charcole/LCDZapper/Images/LCDZapperPro4.jpg

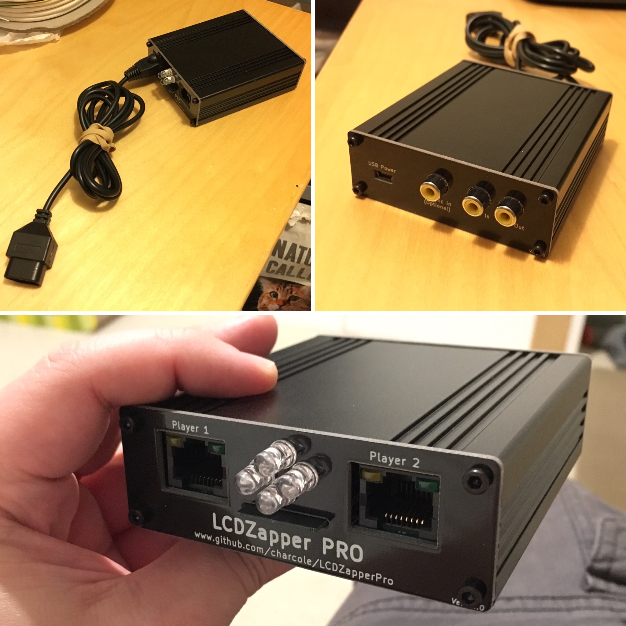
Images/LCDZapperPro4.jpg
