charcole/LCDZapper/Images/LCDZapperPro.jpg

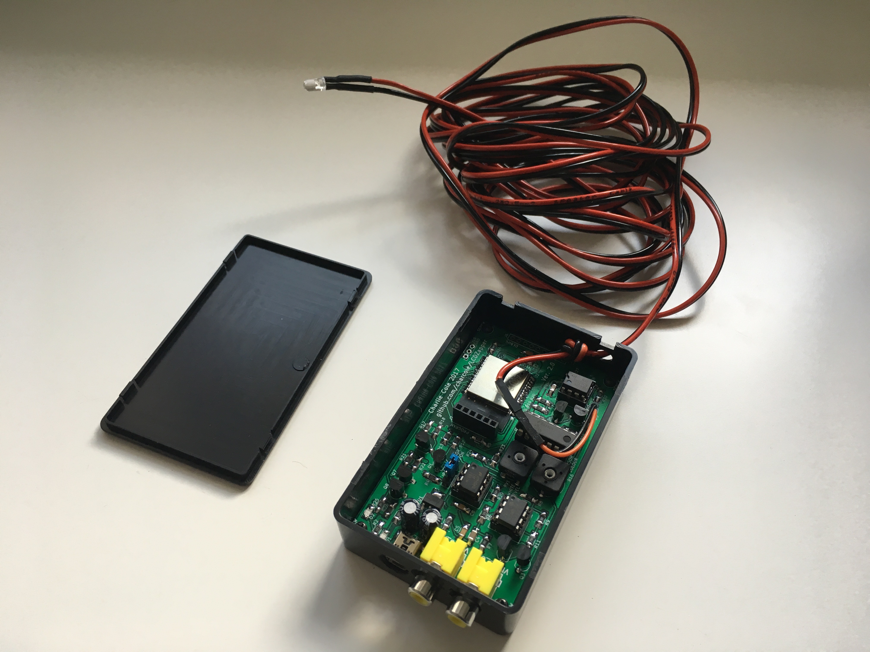
Images/LCDZapperPro.jpg
