charcole/LCDZapper/KiCad/SCARTBreakout/3DModel.png

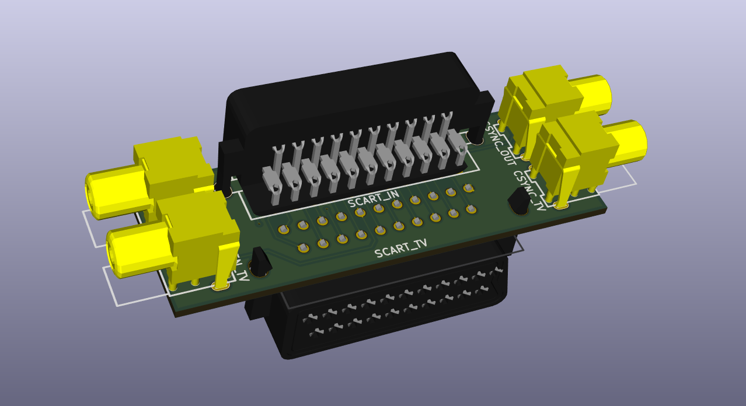
KiCad/SCARTBreakout/3DModel.png
