charcole/LCDZapper/OriginalPrototype/AnalogueBoard.jpg

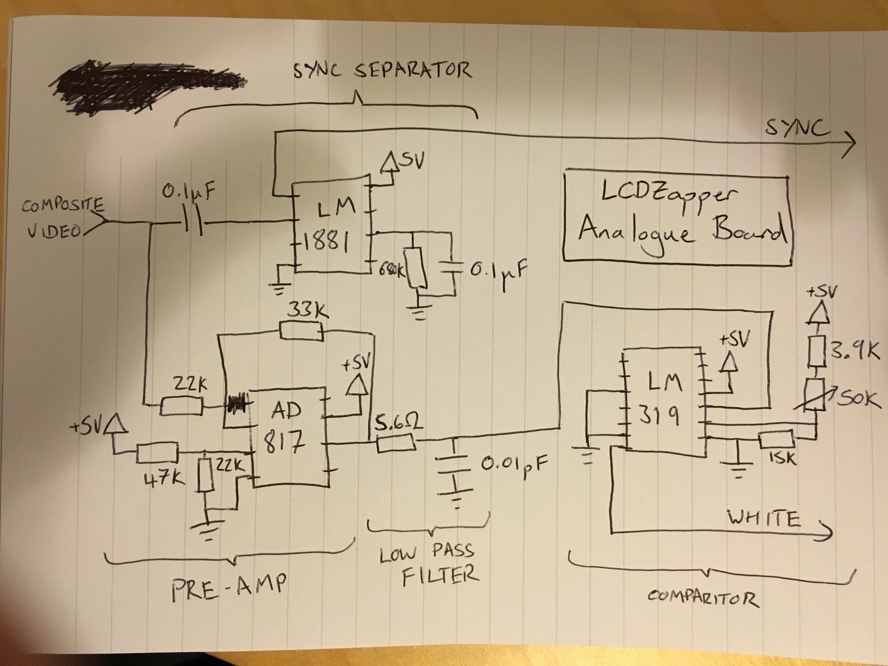
OriginalPrototype/AnalogueBoard.jpg
