charcole/LCDZapper/(threads)

Thread 1 (2016-08-31):

Schematic and board creation

muramasatheninja, 2016-08-31:
Hi,

Very excited to see this project. I wasn't sure the best way to contact you so I figured I would post an issue here.

I started on converting your hand drawn schematic.
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

The goal is to make a self contained board that would fit in a small enclosure.

Thanks

muramasatheninja, 2016-09-02:
One thing I'm a little confused about is how the 2N7000 is used to add the reticule on the screen. I looked pretty closely at your video to see how you had it setup but wasn't able to spot it. Is there any reason to use a transistor over say just a switch to switch the video between the resistor and one that let's the signal straight through?

dlcboy, 2016-09-21:
First off just let me say this is absolutely brilliant work!!  I've been struggling for years to find a good solution to this problem and you nailed it, home run, out of the park! Bravo! I was actually buying the parts to build a similar albeit less capable system when I stumbled across your work searching to see if anybody had done this for the millionth time, and what a pleasant surprise to see it!

Seeing as how you have it done so well,  is there anything we can do to contribute and make it better? I wondered about making a logic system for the wiimote so that it can track dots actually located at the corners of the tv so there is no need for calibration and the user can move around freely? I could try putting retro reflective stickers on the tv with an ir led light source so they wouldn't need power?  I could work on sensor fusion with the wifi motion plus if you think that could be better with the help of the inertial system to increase accuracy? Your video looked pretty good already I have to say, maybe the wiimote has less noise than I expected.

Btw, muramasatheninja, imho, I suspect the 2n7000 is just being used exactly like you said, as a really fast switch... in its saturation region, just pulling the signal low briefly. Please correct if I'm wrong though!

Thanks again for the great work!! I'm anxious to get this running soon!

ysfgary, 2016-10-24:
Hi, I would like to start this project but I am using NTSC system. Any design I need to change it before I start this project? Thanks.

Catwashere, 2017-01-02:
Pretty sure 2n7000 is to remove saturation.

muramasatheninja, probably you could spot it because is attached to the input and output
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

charcole, 2017-03-12:
Hi everyone,

First I've got to give a big apology. I never got a notification of this thread. I only spotted it because I'm currently working on a version 2 and wanted to look at my schematic. Thanks for the schematic muramasatheninja. I would add it but I don't want to produce any notifications at the moment as version 2 is quite close now (hopefully!).

The 2N7000 to dim is really dodgy and something I want to improve for the second version. I should say I'm mainly a programmer and not that great at analogue electronics. It worked but I don't think it was correct. The idea was to have another resistor in series with the video signal and short circuit it with the FET. When the FET was off the signal would go through the resistor causing some voltage to be dropped and therefore the display to dim. And when on it should let the signal through with only a slight drop in the FET.

However it's dodgy because the DC bias of a video signal is not set. It worked fine on the NES as it was about 3V. In more modern systems it tends to be 0V which means the signal is negative for half the time. When negative the current will flow through the diode in the FET and the gate to source voltage can go positive even when grounded. It seemed to work in this configuration but I wasn't very happy with it and the 2N7000 tended to die randomly and need replacing (too much current through the diode or static?). Also if the DC bias was high the resistor would cause the screen to dim more than if it was low.

For version 2, I was planning on improving this by putting the signal through a capacitor so I can fix the DC bias and then to an op-amp. This way the DC levels and driving circuitry is a known quantity. From there I can use two 2N7000s to switch between that output and a variable voltage source. This way the cursor can be more visible and there can be a pot to change between a white and black cursor.

In case people are interested, the other changes I was planning for V2, is replacing the Raspberry Pi and Arduino with an ESP32. It has bluetooth built in and I have it working with a Wiimote (it works a lot more reliably than with the Pi too as a bonus). The ESP32 is dual core so the other core can be used to do the precision timing needed to pick out parts of the frame (what the Arduino used to do). However the ESP32 also has a peripheral that should be able to do it without much CPU time so that's what I'm planning to use. Finally I'm going to use a 555 timer to use the dimming signal and the output from the comparator to flash the LED so the ESP32 don't need to listen to the white level like the Arduino did. Tested everything in stages, just need to go through and build it up. In all it should be a much neater product and have better tolerances than the old RPi/Arduino method.

Thanks,
Charlie

charcole, 2017-03-12:
dlcboy: Zero calibration would be good. I'm wondered about adding four IR LEDs to the corner of the TV. Problem would come if the system could only see one LED and it wouldn't know what corner it was seeing. You could try and keep track of the points (last time I saw one around here it was the top left LED). Your idea of using the accelerometer could add some more data to this to make it more accurate. Or the micro could control the LEDs and flash them in sequence if unsure which it was looking at. It's something that's on my mind but will try and get V2 working first. It'd just be software from then on.

ysfgary: Hi. NTSC would be cool. I think the only thing that'd need to change would be the timings and the line number calculations. It shouldn't need hardware changes. Might be worth waiting for V2 now though.

Catwashere: Good spotting

Catwashere, 2017-03-13:
Can't wait to see V2 and see if you convince me to buy an ESP32.

Please this time put the schematic hahahaha.

Greyneon, 2017-03-16:
Was looking at this about a week ago or so and now i hear about a version 2?

I am SO subscribing to this!

muramasatheninja, 2017-03-24:
Thanks for the update. Definitely looking forward to Version 2!

charcole, 2017-04-03:
Another quick update for you all. Got the Version 2 working at the weekend on strip board. This is the new analogue board with the ESP32 handling Bluetooth (for Wiimote) and generating the video overlay. Video overlay stability is a lot better this time around. Next steps are to make a schematic (probably in KiCad) and layout a PCB so it can be sent off to be fabricated. Hopefully that shouldn't take too long.

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

Greyneon, 2017-04-10:
Awesome news! Can't wait :D

Catwashere, 2017-04-10:
Me too

charcole, 2017-04-15:
Another update for you. So, last week I finished off laying out the PCB and sent it off to the fabricators. Expecting the first batch of boards back in the next couple weeks. From there I just need to assemble them to ensure I didn't mess anything up and improve the software side of things ready for release.
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

dlcboy, 2017-04-15:
Awesome work!! I'm so excited to see this moving along!!!! When it went quiet I had thought you might have moved on to something else. I tried and tried to get wii library support working on my pi and just failed, so I'm super excited to have something that's more robust and a bit more dedicated to this one task (which I will be using 100% of my free time of course;) are you making a handful of boards? Can I help in any way? I'd be happy to assemble or solder if you are doing it yourself. Also happy to help by donating enough beer to the cause to make it less painful too;)

 I can't wait to get one running to try out different sensor fusion schemes, and becon setups. I feel like it's pretty important for these old games to have dead on accuracy with minimum latency. Keep up the good work!! I can't wait to have duck hunt on my giant 2016 hdtv:D

charcole, 2017-04-16:
Thanks. Yeah, didn't have much free time the past year or so due to work but hopefully will start doing some more home projects again. I'm sure I'll have messed up something on these first batch of boards but if not I'm happy to send any left over unpopulated ones out if anyone wants one. I've just had confirmation they should get delivered on Thursday. As for completed boards, if I decide to sell some the PCB fabricators should be able to do almost all the assembly for a pretty reasonable cost but thanks for the offer. Whatever I do or not though, everything you'll need to build one will still get added to github.

Catwashere, 2017-04-17:
I'm in charcole, but I live in México. If you send me you paypal and cost I pay for the shipment.

jbp11, 2017-04-19:
This is fantastic!  I would gladly purchase a board.

charcole, 2017-04-20:
I said the boards should be here today so thought I should give another update. They actually turned up on Tuesday so I've already had time to populate one and check for mistakes. Surprisingly no major errors so they do work. I did make a mistake on the silkscreen (a resistor and capacitor label were switched). All the other problems were mechanical (screw holes too small, RCA jacks sit too high etc) but they don't matter if you aren't trying to fit it into the case I chose.

There are a couple minor issues too. For some reason the vertical position of the detection point jitters by a couple lines which I can't remember happening on my strip board version (it's not too noticeable as there's shake from holding the gun but I want to know what it is). Also one time it booted up and the APB clock seemed to be running at half rate which meant the detection point became stretched. Again, it's not a deal breaker as it came back fine after a reboot but I'd like to know what's going on there too.

As for sending boards out they are only 17 grams so should only be the cost of a letter so happy to pay postage to anywhere. Just to be clear these are just the bare PCBs with no components soldered on. You'll have to source the parts and solder everything, build the programming board (basically a couple switches and a USB to serial adapter) and set up the ESP32 tool chain. Also you might have to wait a while until I release the code and schematics as they are not quite ready yet. If you are still interested though then send me your address at cdcfoscam at yahoo.com and I'll pop them in the mail (I have 4 or 5 I probably won't use). Completed boards (just plug in and play) should be available at some point in the future if I can work out the economics of it.

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

rEd2k, 2017-04-23:
If you can think about possibly building the whole thing and make complete units ready to go, I'm sure people will buy them. You could sell them on websites that offer accessories for retro gaming ect. and since your the ONLY person doing this you can patent the product and be the only person out there that people can get these from making you rich! (Or maybe just more wealthy lol).

My 2 friends and I are already interested in buying a completed module, that's 3 people that will buy it, and all of the people we know that will want one as well and so on... You should really think about manufacturing these and going all the way, there isn't anyone else doing this so you have an edge. I hope you think about it and really consider what I have said, being a business owner myself I can see the potential here! Thank you for your hard work on this project so far, now it's time to take it all the way! ;)

charcole, 2017-04-23:
Thanks rEd2k. I'd certainly like to. Biggest stumbling block after reading up on the subject seems to be FCC regulations (and similar in other countries). Before selling an electronics product it needs to be tested for emissions and reading around it seems like you need to budget at least $10K (probably more like $20K) to get an intentional radiator through. The European regulations (which I'd have to adhere to) are less strict but selling something without doing the right testing could still be a huge fine or even a prison sentence. So starting small and selling a few doesn't seem like it's really an option from what I've read. I'm still investigating though. In the meantime I'm still working on the design, trying to make it as slick as possible. Currently working towards getting it to a state that a friend can beta test it.

rowie4life, 2017-04-24:
Do want.

jlebrech, 2017-04-26:
@charcole just sell as a kit, this is what edtracker did.

you might get away with people only need to solder one component or lead.

charcole, 2017-04-26:
Unfortunately kits are explicitly mentioned as still needing testing. My reading of it is selling the PCB would be fine but the PCB with any number of parts wouldn't. There's is an exemption for subassemblies which this could maybe fall into (and edtracker might) but I'd probably need to talk to someone who knows this area of law.

Other than this, I've been working away improving the circuit and trying out some ideas some friends suggested (adding IR LEDs to work as sensor bar & Wiimote-only mode). I still need to bug fix some of the problems I found (and exist on a second board I assembled). Then I'll do another revision.

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
(Version 2.0 board with a "hat" that'll get built into next revision)

kahhar, 2017-04-29:
Is there any possibility of adding HDMI capability?

I think it would be great to support a standard that seems to have some future lasting power--newer TVs are starting to remove composite and component inputs.

I'd love to be able to play these games on a high quality signal on my HDMI NES and the SNES, Playstation 1/2, and Dreamcast via RGB -> HDMI converters.

Catwashere, 2017-04-29:
@kahhar even if you have an RGB or HDMI mod in your consoles if you don't disable default ports with the mod you can use this, the only feature you will be missing will be the "cheat" cross/circle on the display where you are pointing

Catwashere, 2017-04-29:
@charcole Wiimote-only mode? What does that mean?

IR Led sensor bar it will by a great add on and easy to create because in last revision you need to have a costume sensor bar, a battery sensor bar or a wii connected on.

kahhar, 2017-04-29:
@Catwashere It will still work, but it will still require a composite port (and won't look as nice).

charcole, 2017-04-29:
@Catwashere Wiimote-only mode is playing light gun games without a light gun. In the picture I posted the device has a NES controller plug connected to it and it goes into the NES instead of the Zapper. Then you can play it totally with the Wiimote like a Wii game (A or B cause the trigger pull signal to be sent to the NES). It's just a little extra. I wondered if it might be an easier sell as it's slicker that way. Extra consoles could be supported with different leads (the 8-bit ones being especially easy).

@kahhar Adding HDMI would be a big change and make the device a lot more expensive and difficult to build so I probably won't, sorry. As Catwashere said if you can get composite out as well as RGB (which goes to HDMI convertor or SCART or whatever) it'll still function. The composite signal would go to the device and the RGB off to the TV (the composite output from the device would be left unconnected). You'd lose the reticule that I add but it's mainly useful for calibration and playing Wii style.

Snaid1, 2017-04-30:
I love this idea and can't wait to try it out once you get to the point you're happy with!

just a quick question, would the wiimote-only mode be an option in addition to being able to play with a light gun or would it replace the use of the gun altogether?

charcole, 2017-05-03:
As you might have noticed I've uploaded new Kicad files to a "version2" branch. It's not final (got plenty of ideas to make it better) but it matches the few boards I've sent out and the ones I've been testing with. (Nb. The R10/C3 silkscreen labels are correct in the uploaded file but were wrong on the boards I sent out so take care).

@Snaid1 Yes, the wiimote-only mode is an option. You'll still be able to play with any light gun too, it'll just be two different leads.

ddbehsnilian, 2017-06-10:
@charcole thank you for coming up with this amazing solution! I'd like to follow this project as closely as I can, is this the best place to do so?

charcole, 2017-06-10:
Hi @ddbehsnilian, Yes, this is the best place. Updates have been a bit lacking recently because I haven't had much time to work on it. Hoping to publish the code soon though. If I'm organised I will do it as three projects, this, a standalone Wiimote library and (very niche) a CD-i controller which also use ESP32 & Wiimote.

wilhouse55, 2017-06-25:
I would def be interested in purchasing an NTSC setup that requires as little work on my end as my soldering skills are non-existent!

charcole, 2017-07-01:
Had some time off this week so there's finally been some progress again! :) You should find that the firmware is now released and I've added a description of the little programming board that is needed to update the firmware. I've also updated the README with some descriptions of the new features. As version2 is now more fully featured than the old Raspberry Pi/Arduino solution I've finally merged the version2 branch into master so it'll be the first one you find when visiting the project on github.

The firmware incorporates some hardware design changes I'm planning to make but I think it should still work with the current boards. The bits that won't work are turning off the cursor with the Home button (on the old boards it was a jumper) and two player will always be in co-op mode. I can discuss how to mod the changes into existing boards if anyone wants me to.

Biggest issue left is I've still got to investigate the jitter in the image (which is more noticeable now we have some rudimentary text being displayed). Next big thing is I need to support tracking two spots so you can roll the Wiimotes. I also want to add in a logo on power up to make it a bit cooler looking. I'm also planning on removing the LM1881 from the design as they are expensive to get from proper suppliers (although dirt cheap on eBay). This will require a little bit of code changes to support (but again shouldn't break the existing boards). While I think of it, when in two player it'd be good to have different cursors too. Sure I'll think of more things to improve but the version committed should be a decent first release.

ddbehsnilian, 2017-07-02:
This is fantastic news! Are you giving any thought into adding support for NTSC signal as well as PAL? If you're planning on selling this solution that would considerably enlarge the market for it. I hope you can put whatever time you think is necessary into making this a great product.

charcole, 2017-07-02:
I have indeed. All the timing constants are grouped together in one place. As the line frequency of NTSC and PAL are very similar only TIMING_VISIBLE_LINES probably needs changing to get it to work. There are a bunch of others in the group but mainly they only need adjusting to maintain aspect ratios. The current set of constants were just eye-balled so I probably need to revisit them and set them to proper PAL timings. When I do that I'll add the NTSC timings too.

charcole, 2017-07-02:
Committed a few new changes this evening...
- Jitter problems have been much improved (Not completely fixed yet as not sure why it's happening)
- Added logo on boot
- Replaced low resolution (12 by 5 pixel) text with images
- Made code change that allows removal of LM1881 (works off composite sync only)
- Player 2 now has a different shaped reticule (a diamond)

So that leaves (on the software side of things) a proper jitter fix, tracking two spots for controller roll and finalising PAL/NTSC timings.

cr4zymanz0r, 2017-07-09:
Is there a list of what all lightguns this has been found to be compatible/incompatible with?
I'm very curious if it works with PS2 Guncons So i can play Time Crisis 2 and 3.

charcole, 2017-07-09:
It should be universal so PS2 should work fine. I have been slowly gathering up light guns and consoles to test including PS2. In my original video I think I did NES, Saturn and Dreamcast. I've now also got Master System, PS1 and PS2. I'm missing a Superscope and Menacer but I hope to be able to borrow those. I've also got a Lethal Enforcers JAMMA arcade board being delivered that I plan to test with it too. That should cover most things people will want to use with it.

cr4zymanz0r, 2017-07-09:
I greatly appreciate this project since one of the main reasons I've been unable to get rid of aging CRTs is due to needing them for lightgun games. When using RGB output from consoles paired with devices such as the Framemeister or OSSC (no lag added!) these old console look stunning on HDTVs. Lightgun compatibility with LCDs is one of the last things I need for a "perfect" setup. I don't what your final plans are for the layout of this, but I thought I'd just give my thoughts as feedback.

1.) All of my retro consoles are using RGB with csync. I'm hoping I can just feed the csync into your device and then send the output from the device to my upscaler/whatever (or not send the output and just not have extra features like the on-screen cursor?)

2.) Strapping a wiimote to each light gun is probably the simplest solution with it being easily available, but it adds more weight and isn't very elegant in my opinion. Is the wiimote being used soley for IR tracking (and bluetooth for connectivity)? I didn't know if there's some mass produced components that could be used instead and just modded into the light guns. If not, I wonder if the bare wiimote PCB is small enough to be put into lightguns (and needed buttons added externally) all while possibly being able to be powered by the voltage provided to the light gun from the console.

I realize it would be impractical for you to be modding every single light gun per order, but it could be an option for a kit such as:
Kit A - most consumer friendly version meant for strapping a wiimote
Kit B - For more advanced users/modders that want a more elegant integrated solution.

charcole, 2017-07-09:
Yeah, the real problem is making a product enough people will want to buy to make it worth while. I remember hearing about some people who were modding Dreamcast Guns to fit Wiimote internals in them. I haven't looked into it though. Seemed like a very low volume thing. Similarly there are some old commercial IR based light-guns out there (for CD-i/PS3 etc) but they are expensive and hard to find. Most people probably have a Wiimote already (so free) although as you say not the most elegant solution.

Thanks for your comments on csync. The sync separator and video pass-through are different circuits so I could make a small modification to the board to allow you to optionally provide a separate csync signal and have the overlay added to whatever colour channel you pass through the normal composite video path. I'll experiment with that when my arcade board turns up as that'll be RGB with CSYNC. I'll then incorporate it into the next version of the board.

retrorgb, 2017-07-10:
I think there would be a ton of interest in this.  Would you be able to do a skype interview for my podcast and see what people think?  Please contact me if you're interested:  http://www.retrorgb.com/contact.html

ddbehsnilian, 2017-07-10:
Hope you accept the invite! @retrorgb does a great job maintaining the classic gaming community at its peak! His YouTube channel is really worth checking out too http://www.youtube.com/user/RetroRGB

mbrener, 2017-07-12:
Hi I'm building one of these to get two guncon 2 controllers up and running for Tim Crisis 2/3 on PS2. I'm making a few hardware changes and would like to know your thoughts. I'm going to use a NAND gate to drive the 555 timers. I'm also considering using a TXB0108 level converter to shift digital signals between 3V3 and 5V. I've been trying to decide on the video dim circuit. Does it affect the output scalling the input by 2? From what I can tell of your last posted circuit you are using two 2n7000 to disconnect the input signal and connect a ref voltage? How fast does the transition need to stabalise to work? The settling caused by switching of the fets may be contributing to your jitter. Have you considered using a high speed video mux? I found this link for a cheap mux circuit but I think the transitions are too slow (http://www.analog.com/en/analog-dialogue/articles/video-multiplexing-using-high-speed-amplifiers.html ).

charcole, 2017-07-12:
NAND gate and level shifter both sound like a sensible changes. I considered some dedicated video mux ICs but all the ones I found, in the price bracket at least, were too slow so abandoned the idea. I'm sure there are some around that'd be suitable. My switcher does cause some ringing (maybe caused by current draw on op-amp suddenly increasing). The ringing creates an unintentional but not unwelcome drop shadow on the overlay. A whole line's information is about 52 micro seconds so for one SD pixel is something like 80ns, so that's the sort of switching time we're aiming for.

The switching I don't think causes the jitter. The waveforms all look clean. Seems to instead be some interaction between the two cores of the ESP32. Once two Wiimotes are connected the jitter gets worse even though that all runs on a different core. The odd thing is it doesn't effect the horizontal sync in the same way which you'd think would be the harder of the two to get right.

BTW, For the people who are interested I've sent a message to RetroRGB about that interview.

boomchaU2, 2017-07-12:
Just came upon this as my wife is making get rid of my old CRT TV (I'll just relocate to shed, lol). This is a great idea and I will buy an NTSC version when you are ready!

dlcboy, 2017-07-12:
I've got a super scope I can lend you if you need it still.

Sent from my iPhone

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

charcole, 2017-07-13:
@dlcboy Thanks for the offer. I know someone locally with one though.

charcole, 2017-07-23:
Tiny update. Just to say I finally received the Lethal Enforcers JAMMA board I bought a couple weeks back so I've been able to test the device on that and happy to say it works. Another system crossed off the test list! :) I had no gun so wired up a two transistor interface that meant I could plug it directly into the board and play it just with a Wiimote. One new issue I found is there's no calibration settings and shots landed to the left of the cursor (the real light gun must have had a small delay between sensing and triggering). I'll see if I can think of a way of cheaply building this into the next device revision to make correcting these problems easier.

I was playing on my SuperGun with modified SCART cable. The red channel was broken out and fed through the normal composite path so I could add the overlay and the composite sync was fed directly into the LM1881N. For the next version I'll support this better (probably adding another RCA jack for composite sync). The modified SCART cable was a quite flaky (signal dropped out if I moved it) so I've designed a small breakout board and added that to this project in case it helps anyone else. Not tested yet though as waiting for it to be fabricated so be cautious if you do try it. Also RCA jacks are switching ones on that design which don't seem easy to find (or I don't know what to search for).

charcole, 2017-07-25:
I've managed to find the cause for the vertical jitter! :) Very long story short, the timer on the ESP32 doesn't seem to latch consistently unless you read the full 64 bit value (first the high 32bits then the low 32bits). The timer should only increment the upper 32-bits every 100 seconds so I didn't bother reading it in the original code. To read from the timer on the ESP32 you first have to latch it, then read the latched value. When only reading the lower bits the old value was sometimes read twice (ie. the latch didn't work or didn't happen before the read happened). This meant vsyncs were missed or extra vsyncs were detected causing the picture to jitter up and down. Adding nops between the latch and read caused it to be much more stable but pointlessly reading the upper 32-bits of the timer caused the jitter to go entirely. Couldn't find anyone else reporting it but I could believe it's a bug in the chip or the documentation.

wilhouse55, 2017-07-25:
amazing that you could find it! good job!

On Tue, Jul 25, 2017 at 4:18 PM, charcole
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

Thread 5 (2017-11-26):

ESD Protection for external GPIO lines

charcole, 2017-11-26:
IO line connected to MOSFET gate in particular has no ESD protection

charcole, 2018-04-18:
Newest board design has TVS diodes protecting the MOSFET. Needs testing

Thread 6 (2017-11-26):

IO Type in menu is non functional

charcole, 2017-11-26:
IO Type should change what the two IO lines do...

Normal: A or B, Serial Data (all buttons + coordinates)
A + B: A, B
B + A: B, A

Also inverted versions for console needing active high

charcole, 2018-07-03:
Should be functional now

Closed 2018-07-03.

Thread 11 (2018-04-29):

Guncon2 support?

DieKatzchen, 2018-04-29:
Will it be possible to support the ps2 light gun with this? If I remember correctly the device was USB, so I'm not sure if you're able to emulate a USB device.

charcole, 2018-06-16:
I think the Guncon 2 was a fairly normal lightgun even though it had a USB connection. Should be possible to support it but would need to use the universal solution of putting an LED into the barrel of the PS2 light gun and strapping a Wiimote to the side of the gun

DieKatzchen, 2018-06-16:
I mean, it can be even simpler. The wiimote gives absolute pointer position and the Guncon 2 gave absolute mouse position.

charcole, 2018-06-16:
Yeah, it'd definitely be possible to do it that way. You'd need some extra circuitry to mimic the USB device though. I'm planning on adding a serial output option for people that want to build external circuitry to interface to other systems directly. CDi is like that too (not that there's many good games on that system).

DieKatzchen, 2018-06-16:
That's probably easily done. Could probably even do it with a digispark or trinket.

charcole, 2018-07-03:
Serial output should be available by setting the IOType setting to Serial. This should enable this use. It currently outputs 0x80 (upper bit set to detect start byte), player number, upper 7 bits of X, lower 7 bits of X, upper 7 bits of Y, lower 7 bits of Y, upper 7 bits of buttons, lower 7 bits of buttons.

Closed 2018-07-03.

Thread 12 (2018-06-07):

Branching

JesusFork, 2018-06-07:
This is not an issue, but I am new on GitHub and not sure where comments are inserted.
I am interested in this project, but from a different use. They are currently lots of emulators and some run on the pi directly. Do you think it is possible to apply part of this code to determine if the duck has been shot to tell the emulator? Basically just having a pi and a Wiimote.

DieKatzchen, 2018-06-09:
There's a product called Dolphinbar that presents the wiimote as a mouse. You could also connect directly to the pi if it has bluetooth and use software to translate to mouse movements. No need to reinvent the wheel here.

Dolphinbar costs about $20 and should just work. Software would require you to go off the beaten path and install something on the command line, might not work, but would be free. Up to you.

Thread 16 (2018-09-02):

Build Log

arithmaldor, 2018-09-02:
I'm going to try my hand at building one of these. I am logging my progress [here](https://tinkerplunk.com/lightgunverter-build-log/). If anyone sees any issues or things I get wrong please let me know, and @charcole has been gracious enough to answer my questions. I will post any further questions here as I go.

arithmaldor, 2018-09-02:
So are the 4 LEDs on the front supposed to be IR or are they for decoration? I don't know how they'd function as a sensor bar without being spaced out, or can the Wii remote function with only one point of reference?

arithmaldor, 2018-09-02:
Found the answer
https://github.com/charcole/LCDZapper/issues/1#issuecomment-341992825
Only needs location, not rotation, so it works with one spot

charcole, 2018-09-02:
Yes, sorry you beat me to it. I've been thinking recently about adding better software support for standard light bars too but I've not had much problem with the single reference point.

The LEDs needs to be IR as you worked out. They just work together to form one big spot. I'd suggest using 940nm IR LEDs as I think the Wiimote is more sensitive to them. Also get ones with the biggest spread you can find so it'll work from more angles.

arithmaldor, 2018-09-16:
PCB fab takes a while, should have gone with express shipping from jlcpcb. It is so funny to me that the pcb files specifically say "manufacturere marks on this side please" and they still put them on the outside. Front and back panels are the only ones here, main board should be here next week and I can start building. @charcole is there any documentation on the cables? I have all of the systems supported or soon to be supported by just wii remote except saturn (sold sadly). I think I have an ethernet crimper around here somewhere...

charcole, 2018-09-17:
Yeah, I normally have to specifically request manufacturer's marks on the rear silkscreen. Only used pcbway but they've done followed the instructions every time so far. As you saw I also added it on the silkscreen to try and make extra sure.

There isn't good documentation on cables at the moment but I'm hoping to get that done soon. I've got to make some guides for the person manufacturing the commercial cables so I should be able to put the same documentation up.

arithmaldor, 2018-09-27:
Finished the build, just waiting on a programmer. I've got some other projects going on so I'm not in a big rush to build the cables, I'll make them whenever the guides are ready. Turned out really well I think.

charcole, 2018-09-27:
Awesome! Well done, Jacob! I’ll get the cable plans ready as soon as I can. Hope you enjoy it when it’s finished!

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

arithmaldor, 2018-10-15:
Hey @charcole I've got the board assembled but I'm not experienced with programming or compiling the firmware. I downloaded the toolchain, pointed it at the folder, and used the make command but got nothing. I'll have to look and see exactly what error I got, but do you have any tips?

Also, [this](https://rover.ebay.com/rover/0/0/0?mpre=https%3A%2F%2Fwww.ebay.com%2Fulk%2Fitm%2F253056283240) is the programmer I got, but I'm not exactly sure which lines to hook up or if this is the right kind.

SuperVehicle-001, 2018-11-09:
Hi @charcole, thank you for making your project open source (non-commercial).  I think my board is mostly functional.  It displays the logo overlay w/ composite in/out setup.  I messed around a little with csync input for RGB setup, but really have no idea how to proceed from here with pairing wiimotes and building cables.   Thanks @arithmaldor for the blog write-up, would not have attempted without it.

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

arithmaldor, 2018-11-09:
Awesome work @SuperVehicle-001 ! Any tips on programming? That's where I stalled as I have next to no experience with that.

Heath3827, 2019-07-27:
Do you have more concise instructions on how to build? A proper diagram and parts list? I'd like to build one but as a hobbyist (not an engineer or programmer) I would need more monkey see - monkey do instructions, preferably not using surface mount components (I have no experience soldering such tiny components). Otherwise is there the ability to acquire a unit? I just want to play Duck Hunt and Metal Combat again.

arithmaldor, 2019-07-31:
my build log is about as step by step as you're going to get, and the board is designed with surface mount components, so you're not going to get through hole parts without redesigning the whole thing. Can be reserved at lightgunverter.com

IDBurner, 2019-08-13:
@arithmaldor Did you ever have luck with the programmer?

Also can anyone point me in a direction to make a Dreamcast Cable for this?

pattonthompson, 2019-09-05:
Arithmaldor your build guide is awesome.  I can handle the soldering.  I too am not sure about the programming.  Can anyone provide instructions on how to do the programming and flash the firmware?  Would be greatly appreciated!

dekkit, 2020-11-30:
Are there any recommended tools to compile the fireware code / get the toolchain sorted.   When i get a bit of time i wouldnt mind having a crack at adding the psx serial settings.

Any links to tutorials /software would be most helpful.

Also is there a factory default .bin in case i bork it that i can manually flash back on?

charcole, 2020-12-01:
The toolchain should be the standard ESP32 IDF (https://docs.espressif.com/projects/esp-idf/en/stable/get-started/). Has been a while so might be some issues with the newest version but hopefully nothing too difficult to solve. I can find the exact revision I used if you have problems. If it asks a bunch of questions making for the first time you can probably just accept the defaults as they will all be new features added to the SDK since I last used it.

The programming over WiFi is easiest but it is also easy to brick if you only have that method as the new firmware has to work well enough to trigger and run the firmware update code. The create_image.sh script is what turns the linkers output into a file that the LightGunVerter firmware updater accepts (it just appends LGV_FIRM to the start).

To mitigate the risk of bricking I'd suggest getting a ESP32 dev board like this (https://ebay.us/yJ2HjH) so you can program using the serial 'make flash monitor' method. Ensure this new firmware can go through the WiFi update process without bricking before writing it to your LightGunVerter.

To reprogram a bricked device (or to program a fully built one for the first time) you need to do so via serial. This is where it gets a bit complicated. I used a serial to USB adapter like this (https://www.ebay.co.uk/itm/USB-To-TTL-FT232RL-FTDI-Serial-Adapter-Converter-Module-For-Arduino-3-3V-5V-Mini/222727769676) and you can just stick it in the programming holes on the board at an angle (or solder a header on if you want it more secure). You do have to get it the right way round of course (I'd check the GNDs match). Finally there's the problem that the 3.3V supply of that module can't supply the whole board so I also added a beefier 3.3V regulator to it. The inputs for the regulator coming from 5V and GND on the programmer and the output going to the middle pin of the jumper (with the jumper removed). You might also be able to do it by removing the jumper and then powering both the board and the serial adapter at the same time from the same USB port (via a passive hub). Been too long for me to remember if that is a good idea to do or not. Finally you need to trigger the serial update process. For this there are two buttons (reset and upload) on the board. On the production board these might have been unpopulated to save cost. The upload button needs to be held while you press reset. Then go to your computer and run 'make flash monitor' and that should connect, reprogram the flash, reboot and then show you the boot TTY. You might need to do 'make erase_flash' if you've already updated via WiFi before programming otherwise the other partitions might still have the old firmware.

In the interests of sharing knowledge, for production I used a programmer like this (https://www.ebay.co.uk/itm/Programmer-Tool-ESP32-Adapter-Socket-Kit-For-ESPRESSIF-ESP-WROOM-32-Module-OS/373373097299) to program all the ESP32 modules and test them before soldering to the board and from then on used WiFi for any last minute patches. Really love these programmers. They act just like the dev boards but you can easily add and remove bare ESP32 modules. Did save me making some duff boards because even getting ESP32 modules from a reputable supplier like Mouser I ended up with a couple duds.

dekkit, 2020-12-07:
Awesome thanks, much useful info.  Ill see how i go!

dtran86, 2021-01-05:
Would someone here be able to program the lightgunverter to work with this system instead of a wiimote. It's similar to how the wiimote tracks coordinates with the same ir cam, but 1:1 and no calibration needed. http://forum.arcadecontrols.com/index.php?topic=161189.0

Thread 19 (2020-11-23):

Nes Zapper Cable

dekkit, 2020-11-23:
Documenting examples of each cable wiring  (in case anyone needs to create additional nes ones, build their understanding of how the system works). Ive included a few photos and original schematic (as drawn by charcole)

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

charcole, 2020-11-23:
Thanks Dekkit, this is great. To share some more details. They were made from NES controller extender cables. These are only wired for a joypad so I had to crack open the shells and move the Strobe/Data pins over to the other side of the socket (to become Photosensor/Trigger) then glue the shell back shut. Then the female connector was snipped off and the wires crimped in the right order into the RJ45 jack.

Looks like the diagram I showed you is wrong. The photosensor and 5V lines need to be switched (at the NES jack).

dekkit, 2020-11-24:
Thanks for confirming!

I did a nes zapper conversion a few years back from a famicom dsub15pin to nes socket and had to do example the same! (pull the pins out and reconfigure a cheap nes extension cable).

Ill draw this up properly but combine your comments and info from here i used ages ago.
http://nesdev.com/zapper_to_famicom.txt

Thread 20 (2020-11-24):

Universal Mode Cable

dekkit, 2020-11-24:
Example cable for Universal Mode

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

Need to confirm if there anything special regarding of 3.3v LED used at end of cable (ie white or an ultraviolet/ IR style)

charcole, 2020-11-24:
I chose to use a bright blue LED. I believe photosensors used in light guns tend to be most sensitive to blue which was the reason for using that.

The drop of the LED and internal protection diode will around 3.5V so the internal 100 ohm resistor should limit current to around 15mA.

White LEDs are lighting a phosphorous so might not have as quick a response which will reduce the tweaks you can make to the horizontal hit position.

Thread 21 (2021-02-17):

compile and upload the program

Verni82, 2021-02-17:
Hello, I've tried a lot of ways and unfortunately haven't managed to compile the software and flash it onto the chip. I hope someone can help me.

1. try: quick way
 I flash the ESP32 with the help of the Arduino(1.8.13) IDE example: OTA Web update in order to use the existing Firmware file. When loading the file, the error message: Wrong Magic Byte appears.

2. try long way
I installed Ubuntu on a VM and followed the steps according to the instructions. (I installed Ubuntu on a VM and followed the steps according to the instructions.) After the successful test with the Hello World example, I wanted to create and upload the firmware. I continued with the instructions from the Programmer.md file. I loaded the existing SKConfig and started make flash.
Ich denke hier gibt es ein Paar probleme mit den Bibliotheken.
`XX build/main/main.o
In file included from /home/alex/esp/Firmware/main/main.cpp:33:
/home/alex/esp/esp-idf/components/esp_event/include/esp_event_loop.h:2:2: warning: #warning "esp_event_loop.h is deprecated, please include esp_event.h instead" [-Wcpp]
 #warning "esp_event_loop.h is deprecated, please include esp_event.h instead"
  ^~~~~~~
In file included from /home/alex/esp/Firmware/main/main.cpp:41:
/home/alex/esp/esp-idf/components/esp32/include/rom/rtc.h:1:2: warning: #warning rom/rtc.h is deprecated, please use esp32/rom/rtc.h instead [-Wcpp]
 #warning rom/rtc.h is deprecated, please use esp32/rom/rtc.h instead
  ^~~~~~~
In file included from /home/alex/esp/Firmware/main/main.cpp:42:
/home/alex/esp/esp-idf/components/esp32/include/rom/cache.h:1:2: warning: #warning rom/cache.h is deprecated, please use esp32/rom/cache.h instead [-Wcpp]
 #warning rom/cache.h is deprecated, please use esp32/rom/cache.h instead
  ^~~~~~~
/home/alex/esp/Firmware/main/main.cpp: In function 'void WiimoteTask(void*)':
/home/alex/esp/Firmware/main/main.cpp:699:8: error: 'UART1' was not declared in this scope
    if (UART1.status.txfifo_cnt == 0 && UART2.status.txfifo_cnt == 0)
        ^~~~~
/home/alex/esp/Firmware/main/main.cpp:699:40: error: 'UART2' was not declared in this scope
    if (UART1.status.txfifo_cnt == 0 && UART2.status.txfifo_cnt == 0)
                                        ^~~~~
/home/alex/esp/Firmware/main/main.cpp:736:8: error: 'UART1' was not declared in this scope
    if (UART1.status.txfifo_cnt == 0) // UART FIFO is zero
        ^~~~~
/home/alex/esp/Firmware/main/main.cpp: In function 'void WifiInitAccessPoint()':
/home/alex/esp/Firmware/main/main.cpp:1684:21: warning: 'void tcpip_adapter_init()' is deprecated [-Wdeprecated-declarations]
  tcpip_adapter_init();
                     ^
In file included from /home/alex/esp/esp-idf/components/esp_netif/include/esp_netif.h:35,
                 from /home/alex/esp/esp-idf/components/esp_event/include/esp_event_legacy.h:22,
                 from /home/alex/esp/esp-idf/components/esp_event/include/esp_event.h:26,
                 from /home/alex/esp/esp-idf/components/esp_wifi/include/esp_wifi.h:64,
                 from /home/alex/esp/Firmware/main/main.cpp:32:
/home/alex/esp/esp-idf/components/tcpip_adapter/include/tcpip_adapter.h:34:6: note: declared here
 void tcpip_adapter_init(void)  __attribute__ ((deprecated));
      ^~~~~~~~~~~~~~~~~~
/home/alex/esp/Firmware/main/main.cpp:1684:21: warning: 'void tcpip_adapter_init()' is deprecated [-Wdeprecated-declarations]
  tcpip_adapter_init();
                     ^
In file included from /home/alex/esp/esp-idf/components/esp_netif/include/esp_netif.h:35,
                 from /home/alex/esp/esp-idf/components/esp_event/include/esp_event_legacy.h:22,
                 from /home/alex/esp/esp-idf/components/esp_event/include/esp_event.h:26,
                 from /home/alex/esp/esp-idf/components/esp_wifi/include/esp_wifi.h:64,
                 from /home/alex/esp/Firmware/main/main.cpp:32:
/home/alex/esp/esp-idf/components/tcpip_adapter/include/tcpip_adapter.h:34:6: note: declared here
 void tcpip_adapter_init(void)  __attribute__ ((deprecated));
      ^~~~~~~~~~~~~~~~~~
In file included from /home/alex/esp/esp-idf/components/esp_timer/include/esp_timer.h:45,
                 from /home/alex/esp/esp-idf/components/freertos/port/xtensa/include/freertos/portmacro.h:46,
                 from /home/alex/esp/esp-idf/components/freertos/include/freertos/portable.h:52,
                 from /home/alex/esp/esp-idf/components/freertos/include/freertos/FreeRTOS.h:64,
                 from /home/alex/esp/Firmware/main/main.cpp:23:
/home/alex/esp/Firmware/main/main.cpp:1685:57: warning: 'esp_err_t esp_event_loop_init(system_event_cb_t, void*)' is deprecated [-Wdeprecated-declarations]
  ESP_ERROR_CHECK(esp_event_loop_init(event_handler, NULL));
                                                         ^
/home/alex/esp/esp-idf/components/esp_common/include/esp_err.h:119:31: note: in definition of macro 'ESP_ERROR_CHECK'
         esp_err_t __err_rc = (x);                                       \
                               ^
In file included from /home/alex/esp/esp-idf/components/esp_event/include/esp_event.h:26,
                 from /home/alex/esp/esp-idf/components/esp_wifi/include/esp_wifi.h:64,
                 from /home/alex/esp/Firmware/main/main.cpp:32:
/home/alex/esp/esp-idf/components/esp_event/include/esp_event_legacy.h:239:11: note: declared here
 esp_err_t esp_event_loop_init(system_event_cb_t cb, void *ctx) __attribute__ ((deprecated));
           ^~~~~~~~~~~~~~~~~~~
In file included from /home/alex/esp/esp-idf/components/esp_timer/include/esp_timer.h:45,
                 from /home/alex/esp/esp-idf/components/freertos/port/xtensa/include/freertos/portmacro.h:46,
                 from /home/alex/esp/esp-idf/components/freertos/include/freertos/portable.h:52,
                 from /home/alex/esp/esp-idf/components/freertos/include/freertos/FreeRTOS.h:64,
                 from /home/alex/esp/Firmware/main/main.cpp:23:
/home/alex/esp/Firmware/main/main.cpp:1685:57: warning: 'esp_err_t esp_event_loop_init(system_event_cb_t, void*)' is deprecated [-Wdeprecated-declarations]
  ESP_ERROR_CHECK(esp_event_loop_init(event_handler, NULL));
                                                         ^
/home/alex/esp/esp-idf/components/esp_common/include/esp_err.h:119:31: note: in definition of macro 'ESP_ERROR_CHECK'
         esp_err_t __err_rc = (x);                                       \
                               ^
In file included from /home/alex/esp/esp-idf/components/esp_event/include/esp_event.h:26,
                 from /home/alex/esp/esp-idf/components/esp_wifi/include/esp_wifi.h:64,
                 from /home/alex/esp/Firmware/main/main.cpp:32:
/home/alex/esp/esp-idf/components/esp_event/include/esp_event_legacy.h:239:11: note: declared here
 esp_err_t esp_event_loop_init(system_event_cb_t cb, void *ctx) __attribute__ ((deprecated));
           ^~~~~~~~~~~~~~~~~~~
In file included from /home/alex/esp/esp-idf/components/esp_timer/include/esp_timer.h:45,
                 from /home/alex/esp/esp-idf/components/freertos/port/xtensa/include/freertos/portmacro.h:46,
                 from /home/alex/esp/esp-idf/components/freertos/include/freertos/portable.h:52,
                 from /home/alex/esp/esp-idf/components/freertos/include/freertos/FreeRTOS.h:64,
                 from /home/alex/esp/Firmware/main/main.cpp:23:
/home/alex/esp/Firmware/main/main.cpp:1698:65: error: cannot convert 'esp_interface_t' to 'wifi_interface_t'
  ESP_ERROR_CHECK(esp_wifi_set_config(ESP_IF_WIFI_AP, &WiFiConfig));
                                                                 ^
/home/alex/esp/esp-idf/components/esp_common/include/esp_err.h:119:31: note: in definition of macro 'ESP_ERROR_CHECK'
         esp_err_t __err_rc = (x);                                       \
                               ^
In file included from /home/alex/esp/Firmware/main/main.cpp:32:
/home/alex/esp/esp-idf/components/esp_wifi/include/esp_wifi.h:791:48: note:   initializing argument 1 of 'esp_err_t esp_wifi_set_config(wifi_interface_t, wifi_config_t*)'
 esp_err_t esp_wifi_set_config(wifi_interface_t interface, wifi_config_t *conf);
                               ~~~~~~~~~~~~~~~~~^~~~~~~~~
/home/alex/esp/Firmware/main/main.cpp: In function 'void StartAppCPU()':
/home/alex/esp/Firmware/main/main.cpp:1877:2: error: 'cpu_configure_region_protection' was not declared in this scope
  cpu_configure_region_protection();
  ^~~~~~~~~~~~~~~~~~~~~~~~~~~~~~~
/home/alex/esp/Firmware/main/main.cpp:1877:2: note: suggested alternative: 'esp_cpu_configure_region_protection'
  cpu_configure_region_protection();
  ^~~~~~~~~~~~~~~~~~~~~~~~~~~~~~~
  esp_cpu_configure_region_protection
In file included from /home/alex/esp/esp-idf/components/esp_rom/include/esp32/rom/cache.h:18,
                 from /home/alex/esp/esp-idf/components/esp32/include/rom/cache.h:2,
                 from /home/alex/esp/Firmware/main/main.cpp:42:
/home/alex/esp/Firmware/main/main.cpp: In function 'void app_main()':
/home/alex/esp/Firmware/main/main.cpp:1929:31: error: 'DPORT_APPCPU_CTRL_B_REG' was not declared in this scope
  if (!DPORT_GET_PERI_REG_MASK(DPORT_APPCPU_CTRL_B_REG, DPORT_APPCPU_CLKGATE_EN)) {
                               ^~~~~~~~~~~~~~~~~~~~~~~
/home/alex/esp/esp-idf/components/soc/esp32/include/soc/dport_access.h:186:67: note: in definition of macro 'DPORT_GET_PERI_REG_MASK'
 #define DPORT_GET_PERI_REG_MASK(reg, mask)   (DPORT_READ_PERI_REG(reg) & (mask))
                                                                   ^~~
/home/alex/esp/Firmware/main/main.cpp:1929:31: note: suggested alternative: 'DPORT_READ_PERI_REG'
  if (!DPORT_GET_PERI_REG_MASK(DPORT_APPCPU_CTRL_B_REG, DPORT_APPCPU_CLKGATE_EN)) {
                               ^~~~~~~~~~~~~~~~~~~~~~~
/home/alex/esp/esp-idf/components/soc/esp32/include/soc/dport_access.h:186:67: note: in definition of macro 'DPORT_GET_PERI_REG_MASK'
 #define DPORT_GET_PERI_REG_MASK(reg, mask)   (DPORT_READ_PERI_REG(reg) & (mask))
                                                                   ^~~
/home/alex/esp/Firmware/main/main.cpp:1929:56: error: 'DPORT_APPCPU_CLKGATE_EN' was not declared in this scope
  if (!DPORT_GET_PERI_REG_MASK(DPORT_APPCPU_CTRL_B_REG, DPORT_APPCPU_CLKGATE_EN)) {
                                                        ^~~~~~~~~~~~~~~~~~~~~~~
/home/alex/esp/esp-idf/components/soc/esp32/include/soc/dport_access.h:186:75: note: in definition of macro 'DPORT_GET_PERI_REG_MASK'
 define DPORT_GET_PERI_REG_MASK(reg, mask)   (DPORT_READ_PERI_REG(reg) & (mask))
                                                                          ^~~~

/home/alex/esp/Firmware/main/main.cpp:1931:29: error: 'DPORT_APPCPU_CTRL_C_REG' was not declared in this scope
   DPORT_CLEAR_PERI_REG_MASK(DPORT_APPCPU_CTRL_C_REG, DPORT_APPCPU_RUNSTALL);
                             ^~~~~~~~~~~~~~~~~~~~~~~
/home/alex/esp/esp-idf/components/soc/esp32/include/soc/dport_access.h:154:67: note: in definition of macro '_DPORT_WRITE_PERI_REG'
 #define _DPORT_WRITE_PERI_REG(addr, val) (*((volatile uint32_t *)(addr))) = (uint32_t)(val)
                                                                   ^~~~
/home/alex/esp/esp-idf/components/soc/esp32/include/soc/dport_access.h:180:46: note: in expansion of macro 'DPORT_WRITE_PERI_REG'
 #define DPORT_CLEAR_PERI_REG_MASK(reg, mask) DPORT_WRITE_PERI_REG((reg), (DPORT_READ_PERI_REG(reg)&(~(mask))))
                                              ^~~~~~~~~~~~~~~~~~~~
/home/alex/esp/Firmware/main/main.cpp:1931:3: note: in expansion of macro 'DPORT_CLEAR_PERI_REG_MASK'
   DPORT_CLEAR_PERI_REG_MASK(DPORT_APPCPU_CTRL_C_REG, DPORT_APPCPU_RUNSTALL);
   ^~~~~~~~~~~~~~~~~~~~~~~~~
/home/alex/esp/Firmware/main/main.cpp:1931:29: note: suggested alternative: 'DPORT_READ_PERI_REG'
   DPORT_CLEAR_PERI_REG_MASK(DPORT_APPCPU_CTRL_C_REG, DPORT_APPCPU_RUNSTALL);
                             ^~~~~~~~~~~~~~~~~~~~~~~
/home/alex/esp/esp-idf/components/soc/esp32/include/soc/dport_access.h:154:67: note: in definition of macro '_DPORT_WRITE_PERI_REG'
 #define _DPORT_WRITE_PERI_REG(addr, val) (*((volatile uint32_t *)(addr))) = (uint32_t)(val)
                                                                   ^~~~
/home/alex/esp/esp-idf/components/soc/esp32/include/soc/dport_access.h:180:46: note: in expansion of macro 'DPORT_WRITE_PERI_REG'
 #define DPORT_CLEAR_PERI_REG_MASK(reg, mask) DPORT_WRITE_PERI_REG((reg), (DPORT_READ_PERI_REG(reg)&(~(mask))))
                                              ^~~~~~~~~~~~~~~~~~~~
/home/alex/esp/Firmware/main/main.cpp:1931:3: note: in expansion of macro 'DPORT_CLEAR_PERI_REG_MASK'
   DPORT_CLEAR_PERI_REG_MASK(DPORT_APPCPU_CTRL_C_REG, DPORT_APPCPU_RUNSTALL);
   ^~~~~~~~~~~~~~~~~~~~~~~~~
/home/alex/esp/Firmware/main/main.cpp:1931:54: error: 'DPORT_APPCPU_RUNSTALL' was not declared in this scope
   DPORT_CLEAR_PERI_REG_MASK(DPORT_APPCPU_CTRL_C_REG, DPORT_APPCPU_RUNSTALL);
                                                      ^~~~~~~~~~~~~~~~~~~~~
/home/alex/esp/esp-idf/components/soc/esp32/include/soc/dport_access.h:154:88: note: in definition of macro '_DPORT_WRITE_PERI_REG'
 RT_WRITE_PERI_REG(addr, val) (*((volatile uint32_t *)(addr))) = (uint32_t)(val)
                                                                            ^~~

/home/alex/esp/esp-idf/components/soc/esp32/include/soc/dport_access.h:180:46: note: in expansion of macro 'DPORT_WRITE_PERI_REG'
 #define DPORT_CLEAR_PERI_REG_MASK(reg, mask) DPORT_WRITE_PERI_REG((reg), (DPORT_READ_PERI_REG(reg)&(~(mask))))
                                              ^~~~~~~~~~~~~~~~~~~~
/home/alex/esp/Firmware/main/main.cpp:1931:3: note: in expansion of macro 'DPORT_CLEAR_PERI_REG_MASK'
   DPORT_CLEAR_PERI_REG_MASK(DPORT_APPCPU_CTRL_C_REG, DPORT_APPCPU_RUNSTALL);
   ^~~~~~~~~~~~~~~~~~~~~~~~~
/home/alex/esp/Firmware/main/main.cpp:1931:54: note: suggested alternative: 'GPIO_APPCPU_INT_H'
   DPORT_CLEAR_PERI_REG_MASK(DPORT_APPCPU_CTRL_C_REG, DPORT_APPCPU_RUNSTALL);
                                                      ^~~~~~~~~~~~~~~~~~~~~
/home/alex/esp/esp-idf/components/soc/esp32/include/soc/dport_access.h:154:88: note: in definition of macro '_DPORT_WRITE_PERI_REG'
 RT_WRITE_PERI_REG(addr, val) (*((volatile uint32_t *)(addr))) = (uint32_t)(val)
                                                                            ^~~

/home/alex/esp/esp-idf/components/soc/esp32/include/soc/dport_access.h:180:46: note: in expansion of macro 'DPORT_WRITE_PERI_REG'
 #define DPORT_CLEAR_PERI_REG_MASK(reg, mask) DPORT_WRITE_PERI_REG((reg), (DPORT_READ_PERI_REG(reg)&(~(mask))))
                                              ^~~~~~~~~~~~~~~~~~~~
/home/alex/esp/Firmware/main/main.cpp:1931:3: note: in expansion of macro 'DPORT_CLEAR_PERI_REG_MASK'
   DPORT_CLEAR_PERI_REG_MASK(DPORT_APPCPU_CTRL_C_REG, DPORT_APPCPU_RUNSTALL);
   ^~~~~~~~~~~~~~~~~~~~~~~~~
/home/alex/esp/Firmware/main/main.cpp:1932:27: error: 'DPORT_APPCPU_CTRL_A_REG' was not declared in this scope
   DPORT_SET_PERI_REG_MASK(DPORT_APPCPU_CTRL_A_REG, DPORT_APPCPU_RESETTING);
                           ^~~~~~~~~~~~~~~~~~~~~~~
/home/alex/esp/esp-idf/components/soc/esp32/include/soc/dport_access.h:154:67: note: in definition of macro '_DPORT_WRITE_PERI_REG'
 #define _DPORT_WRITE_PERI_REG(addr, val) (*((volatile uint32_t *)(addr))) = (uint32_t)(val)
                                                                   ^~~~
/home/alex/esp/esp-idf/components/soc/esp32/include/soc/dport_access.h:183:46: note: in expansion of macro 'DPORT_WRITE_PERI_REG'
 #define DPORT_SET_PERI_REG_MASK(reg, mask)   DPORT_WRITE_PERI_REG((reg), (DPORT_READ_PERI_REG(reg)|(mask)))
                                              ^~~~~~~~~~~~~~~~~~~~
/home/alex/esp/Firmware/main/main.cpp:1932:3: note: in expansion of macro 'DPORT_SET_PERI_REG_MASK'
   DPORT_SET_PERI_REG_MASK(DPORT_APPCPU_CTRL_A_REG, DPORT_APPCPU_RESETTING);
   ^~~~~~~~~~~~~~~~~~~~~~~
/home/alex/esp/Firmware/main/main.cpp:1932:27: note: suggested alternative: 'DPORT_READ_PERI_REG'
   DPORT_SET_PERI_REG_MASK(DPORT_APPCPU_CTRL_A_REG, DPORT_APPCPU_RESETTING);
                           ^~~~~~~~~~~~~~~~~~~~~~~
/home/alex/esp/esp-idf/components/soc/esp32/include/soc/dport_access.h:154:67: note: in definition of macro '_DPORT_WRITE_PERI_REG'
 #define _DPORT_WRITE_PERI_REG(addr, val) (*((volatile uint32_t *)(addr))) = (uint32_t)(val)
                                                                   ^~~~
/home/alex/esp/esp-idf/components/soc/esp32/include/soc/dport_access.h:183:46: note: in expansion of macro 'DPORT_WRITE_PERI_REG'
 #define DPORT_SET_PERI_REG_MASK(reg, mask)   DPORT_WRITE_PERI_REG((reg), (DPORT_READ_PERI_REG(reg)|(mask)))
                                              ^~~~~~~~~~~~~~~~~~~~
/home/alex/esp/Firmware/main/main.cpp:1932:3: note: in expansion of macro 'DPORT_SET_PERI_REG_MASK'
   DPORT_SET_PERI_REG_MASK(DPORT_APPCPU_CTRL_A_REG, DPORT_APPCPU_RESETTING);
   ^~~~~~~~~~~~~~~~~~~~~~~
/home/alex/esp/Firmware/main/main.cpp:1932:52: error: 'DPORT_APPCPU_RESETTING' was not declared in this scope
   DPORT_SET_PERI_REG_MASK(DPORT_APPCPU_CTRL_A_REG, DPORT_APPCPU_RESETTING);
                                                    ^~~~~~~~~~~~~~~~~~~~~~
/home/alex/esp/esp-idf/components/soc/esp32/include/soc/dport_access.h:154:88: note: in definition of macro '_DPORT_WRITE_PERI_REG'
 RT_WRITE_PERI_REG(addr, val) (*((volatile uint32_t *)(addr))) = (uint32_t)(val)
                                                                            ^~~

/home/alex/esp/esp-idf/components/soc/esp32/include/soc/dport_access.h:183:46: note: in expansion of macro 'DPORT_WRITE_PERI_REG'
 #define DPORT_SET_PERI_REG_MASK(reg, mask)   DPORT_WRITE_PERI_REG((reg), (DPORT_READ_PERI_REG(reg)|(mask)))
                                              ^~~~~~~~~~~~~~~~~~~~
/home/alex/esp/Firmware/main/main.cpp:1932:3: note: in expansion of macro 'DPORT_SET_PERI_REG_MASK'
   DPORT_SET_PERI_REG_MASK(DPORT_APPCPU_CTRL_A_REG, DPORT_APPCPU_RESETTING);
   ^~~~~~~~~~~~~~~~~~~~~~~
/home/alex/esp/Firmware/main/main.cpp:1932:52: note: suggested alternative: 'EXT_CPU_RESET'
   DPORT_SET_PERI_REG_MASK(DPORT_APPCPU_CTRL_A_REG, DPORT_APPCPU_RESETTING);
                                                    ^~~~~~~~~~~~~~~~~~~~~~
/home/alex/esp/esp-idf/components/soc/esp32/include/soc/dport_access.h:154:88: note: in definition of macro '_DPORT_WRITE_PERI_REG'
 RT_WRITE_PERI_REG(addr, val) (*((volatile uint32_t *)(addr))) = (uint32_t)(val)
                                                                            ^~~

/home/alex/esp/esp-idf/components/soc/esp32/include/soc/dport_access.h:183:46: note: in expansion of macro 'DPORT_WRITE_PERI_REG'
 #define DPORT_SET_PERI_REG_MASK(reg, mask)   DPORT_WRITE_PERI_REG((reg), (DPORT_READ_PERI_REG(reg)|(mask)))
                                              ^~~~~~~~~~~~~~~~~~~~
/home/alex/esp/Firmware/main/main.cpp:1932:3: note: in expansion of macro 'DPORT_SET_PERI_REG_MASK'
   DPORT_SET_PERI_REG_MASK(DPORT_APPCPU_CTRL_A_REG, DPORT_APPCPU_RESETTING);
   ^~~~~~~~~~~~~~~~~~~~~~~
make[1]: *** [/home/alex/esp/esp-idf/make/component_wrapper.mk:292: main.o] Fehler 1
make: *** [/home/alex/esp/esp-idf/make/project.mk:635: component-main-build] Fehler 2`

Verni82, 2021-02-17:
3.try
I downloaded the current Tasmota software for the ESP32 and started flashing with FLASH_DOWNLOAD_TOOLS_V3.4.9.2. After all partitions were entered in the tool (boot loader, ...), I replaced the Tasmota.bin with the Firmware.bin. Unfortunately, nothing came of this experiment either

charcole, 2021-02-17:
Hi Verni82,

I talked about this a little bit in the Building Discussion issue (https://github.com/charcole/LCDZapper/issues/16#issuecomment-736833128).

The reason you are getting the deprecated warnings/errors is because the ESP-IDF is always getting updated and as the code hasn't been worked on for a while it's now out of date. You could try and fix them yourself or grab an older version of the IDF. The revision I have is 3b92e85b308578c24f14f57371498303c198c7cb (and the tag was v3.1.1). The code should compile fine with the correct version.

The firmware.bin included in the release is meant for self-updating the commercial releases over WiFi. It's the plain binary just with "LGV_FIRM" appended to the start as a (rather crappy) test that its actually firmware for the LightGunVerter before flashing it. If you remove those 8 bytes at the start you may be able to program using some other method (although I have never tried or know anything about either of the ones you mentioned). I'd think the easiest route would be using the correct IDF and flashing it in the usual way (via 'make flash').

Charlie

Verni82, 2021-02-18:
Hi Charlie,
Thanks for Help :-)

I tested version 3.1.1. But there are problems on the ESp, the firmware there constantly restarts with an error message.
Compiling worked with version 3.3.1, but I'm not sure if everything works. I am currently not getting a picture via video.

charcole, 2021-02-18:
What’s the message? Did you try ‘make erase_flash’? If you do ‘make flash monitor’ after what do you get?

Verni82, 2021-02-18:
Hi Charlie,
I followed the start process with serial monitor via Arduino IDE:
ets Jun  8 2016 00:22:57

rst:0x1 (POWERON_RESET),boot:0x13 (SPI_FAST_FLASH_BOOT)
configsip: 0, SPIWP:0xee
clk_drv:0x00,q_drv:0x00,d_drv:0x00,cs0_drv:0x00,hd_drv:0x00,wp_drv:0x00
mode:DIO, clock div:2
load:0x3fff0018,len:4
load:0x3fff001c,len:5080
load:0x40078000,len:10596
load:0x40080400,len:5716
entry 0x400806c0
 [0;32mI (302) cpu_start: Pro cpu up. [0m
 [0;32mI (302) cpu_start: Application information: [0m
 [0;32mI (302) cpu_start: Project name:     app-template [0m
 [0;32mI (305) cpu_start: App version:      1 [0m
 [0;32mI (309) cpu_start: Compile time:     Feb 18 2021 21:22:28 [0m
 [0;32mI (316) cpu_start: ELF file SHA256:  c6771bf70290348e... [0m
 [0;32mI (321) cpu_start: ESP-IDF:          v3.3.1-dirty [0m
 [0;32mI (327) cpu_start: Starting app cpu, entry point is 0x400811f0 [0m
 [0;32mI (0) cpu_start: App cpu up. [0m
 [0;32mI (337) heap_init: Initializing. RAM available for dynamic allocation: [0m
 [0;32mI (344) heap_init: At 3FFAFF10 len 000000F0 (0 KiB): DRAM [0m
 [0;32mI (350) heap_init: At 3FFB6388 len 00001C78 (7 KiB): DRAM [0m
 [0;32mI (356) heap_init: At 3FFB9A20 len 00004108 (16 KiB): DRAM [0m
 [0;32mI (362) heap_init: At 3FFBDB5C len 00000004 (0 KiB): DRAM [0m
 [0;32mI (369) heap_init: At 3FFCD6A8 len 00012958 (74 KiB): DRAM [0m
 [0;32mI (375) heap_init: At 3FFE0440 len 00003AE0 (14 KiB): D/IRAM [0m
 [0;32mI (381) heap_init: At 3FFE4350 len 0001BCB0 (111 KiB): D/IRAM [0m
 [0;32mI (387) heap_init: At 40096E38 len 000091C8 (36 KiB): IRAM [0m
 [0;32mI (394) cpu_start: Pro cpu start user code [0m
 [0;32mI (188) cpu_start: Starting scheduler on PRO CPU. [0m
 [0;32mI (0) cpu_start: Starting scheduler on APP CPU. [0m
 [0;32mI (189) gpio: GPIO[27]| InputEn: 0| OutputEn: 1| OpenDrain: 0| Pullup: 0| Pulldown: 0| Intr:0  [0m
 [0;32mI (197) gpio: GPIO[14]| InputEn: 0| OutputEn: 1| OpenDrain: 0| Pullup: 0| Pulldown: 0| Intr:0  [0m
 [0;32mI (206) gpio: GPIO[25]| InputEn: 0| OutputEn: 1| OpenDrain: 0| Pullup: 0| Pulldown: 0| Intr:0  [0m
 [0;32mI (216) gpio: GPIO[26]| InputEn: 0| OutputEn: 1| OpenDrain: 0| Pullup: 0| Pulldown: 0| Intr:0  [0m
 [0;32mI (225) gpio: GPIO[16]| InputEn: 0| OutputEn: 1| OpenDrain: 0| Pullup: 0| Pulldown: 0| Intr:0  [0m
 [0;32mI (234) gpio: GPIO[5]| InputEn: 0| OutputEn: 1| OpenDrain: 0| Pullup: 0| Pulldown: 0| Intr:0  [0m
 [0;32mI (243) gpio: GPIO[15]| InputEn: 1| OutputEn: 0| OpenDrain: 0| Pullup: 0| Pulldown: 0| Intr:0  [0m
 [0;32mI (253) gpio: GPIO[19]| InputEn: 1| OutputEn: 0| OpenDrain: 0| Pullup: 0| Pulldown: 0| Intr:0  [0m
 [0;32mI (262) gpio: GPIO[4]| InputEn: 0| OutputEn: 1| OpenDrain: 0| Pullup: 0| Pulldown: 0| Intr:0  [0m
 [0;32mI (271) gpio: GPIO[32]| InputEn: 0| OutputEn: 1| OpenDrain: 0| Pullup: 0| Pulldown: 0| Intr:0  [0m
 [0;32mI (281) gpio: GPIO[0]| InputEn: 1| OutputEn: 0| OpenDrain: 0| Pullup: 1| Pulldown: 0| Intr:0  [0m
WiimoteTask running on core 0
 [0;32mI (305) BTDM_INIT: BT controller compile version [5aed448] [0m
 [0;32mI (305) system_api: Base MAC address is not set, read default base MAC address from BLK0 of EFUSE [0m
SpotGeneratorTask starting on core 1
 [0;32mI (316) gpio: GPIO[21]| InputEn: 1| OutputEn: 0| OpenDrain: 0| Pullup: 0| Pulldown: 0| Intr:0  [0m

I'll try to delete it with the flash tomorrow.

Verni82

charcole, 2021-02-18:
I can’t remember the start up being so verbose but that all looks fine. Seems to have started up OK. I suspect it should be working.

No. It can’t produce a video signal itself. It only overlays on top of the input video. If that helps at all.

Verni82, 2021-02-23:
Hi Charlie,
I created a new VM with Ubuntu 14 and got ESP-IDF3.1.1 to run on it.
I had to erase the flash from the ESP32. Now the ESP also starts with the 3.1.1 version. My Wii controller is also recognized when I press 1 + 2. There are only problems with the image transmission. The signal is not passed on from Video IN to Video Out. Maybe something is broken. Thank you so much for the help. I've already come a big step further.

Verni82

charcole, 2021-02-23:
No problem. Let me know once you've got it all running. Always great to see someone else build one.

If you are getting no video then first check DIM_INV is high (or at least mainly high). If it's low that basically shunts the source video to ground so that DIM and DIM1 can replace it with the overlay. If DIM and DIM1 were playing up I'd still expect you to see something (the overlay would just be additive but it could mess with the sync I guess). If you have an oscilloscope then checking TP3, either side of R19 and R20 and TP7 should get you to where the signal is going missing.

Thread 22 (2021-05-12):

PSX Cable (using Arduino Nano)

dekkit, 2021-05-12:
...Work in progress...more soon

Initial place to upload some wiring diagrams, code edits and instructions on how to build an adapter cable to connect your Wii mote to your PS1/PSX using LCDGunverter.

What you'll need:
- Psx cable with 1x male socket (ie ps1/2 control pad cable extension or old control pad cable from broken controller)
- Cat 5 network cable (with an RJ45 socket)
- Arduino Nano (+ a mini usb cable to connect to pc to program)

Optional - Arduino prototyping /breadboard wires.

Note: You should be able to build this without soldering and using just cable/wire joiners (if your nano comes with pins already soldered on)

**Setting up the Ardunio Nano**
- download Arduino IDE (add links) and drivers
- ... Tbc

**Compile and upload Guncon.ino to Nano**
.....include code update to switch guncon mode and fix compiling issue.

**Wiring PSX to Ardunio**
..
.

**Wiring Arduino to LCDGunverter**
...

**Setting up LCDGunverter to use adapter**
...

**Testing the results**
Fingers crossed

dekkit, 2021-05-16:
@charcole
Can you recall what is happening at the following lines of code with the x and y gun position?

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

Im wondering if there is a pal/ntsc issue with how many lines the nano guncon45 is responding back to the psx.

Also can you recall how many wii remote buttons are being communicated through to the io serial (assuming just A and B?)

dekkit, 2021-05-21:
Further testing...

The Wii mote's Dpad LEFT and RIGHT function as the guncon's A and B button.

Useful to get through game menus.

Was able to get the arduino nano to provide debug info (via adding serial print lines to the .ino filr) and viewing via the Arduino IDE serial terminal window on PC.  Outputs to ps1 seem to be correct from probing the reply outputs.

I still cant explain why the X and Y doesnt seem to work well at all (seems to be certain large chunks of screen area which dont register). This results in the screen flashing as if a normal guncon is pointed away from the screen.

Ill need to probe further with adding further debug lines to my .ino.  I hope the arduino isnt introducing a delay that is throwing out possible video timings but too early to say.

charcole, 2021-05-22:
It shouldn't be a timing issue. GunCon guns do the timing internally which is why they need the composite input (only Konami gun games needs the timing circuitry of LGV). The Arduino sketch just needs to tell the console the coordinates of the cursor. The "Serial" mode on LightGunVerter just sends the coordinates it gets from the Wiimote and the GunX/GunY math converts it to what the PSX expects. From memory I think the Wiimote returns coordinates are 0 to 1024 (X) and 768 (Y) while PSX will expect a time delay for X and a line number for Y. The LGV could return the exact line number, that's what I did for the GunCon 2 cable, but in this version I just did some maths.

X axis is flipped (1023-X). Then scaled ((FlippedX*3)>>8). >>8 (half 8 times) is same as divide by 256 so scaling is 3/256. Then 0x4D (77 in decimal) offsets it left and right. Similarly for Y 11/52 scaling plus 32. This would have been done on PAL so the Y will definitely be wrong as PAL has more lines. X should still be close but might need some tweaking.

Hope that helps.

PS. The button bit flags are shown in https://github.com/charcole/LCDZapper/blob/master/Firmware/main/esp_wiimote.h. You should get everything but the Home button.

dekkit, 2021-05-23:
Awesome thanks for the additional insights, its been a great learning experience working arduino, spi, and seeing how button switches polled and then get encoded.  Hopefully documenting as i go will help others too.

dekkit, 2021-06-05:
Finally success for GunCon45!

Added the . ino that works for me to the first post.

Actual wiring used (updated diagram)
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

Shortened cable, completely removed old control pad wire.

The bad cable was causing all sorts of weird effects.  The benefit however was really understanding how your code works and learning how the ps1 communicates with its control pads via SPI.

Thanks @charcole - it works great now!

dekkit, 2021-06-05:
Finally a working cable
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

Exposed socket, cut wire, and soldered in wires to connect to nano!
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

Point Blank 3 still so much fun!
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

Thread 26 (2022-06-15):

Create a wiimote custom device with arduino for use it instead of a real one

sl1pkn07, 2022-06-15:
Hi

Wiimote is a big device and some times is difficult to fit in the gun

So, is possible create a custom pcb with the wiimote ir camera. 2 microbuttons, one arduino with micro pcb and the hc-05 (arduino BT module(?)) For make a custom little wiimote?

Greetings

Thread 27 (2024-06-12):

any good news about more game console's cable

hpx1984, 2024-06-12:
Hi Sir Charcole
i saw your greate project name of "LCDZapper" and got to know it can support so many old game consoles
but i just saw some informations of the Playstation cable from github ,
could you share more other console cable's information?
i want to try to build it
sorry for trouble you and many thanks your greate project LCDZapper to help all game console lover to can go ahead to play lightgun game on new LCD TV

NES / Famicom
Master System
Saturn
Playstation
Playstation 2
Dreamcast
Lethal Enforcers (Arcade)
original xbox
xbox 360
ps3/ps4
3DO
PCE
SNES
atari2600

dekkit, 2024-09-14:
If you scan through the issues, I've attempted to document how a few of the cables were designed / made - so you can build your own if you're keen.

hpx1984, 2024-09-15:
Dear Sir

yes ,im already review all the issues and got some detail of the PS cable and nes cable&nbsp;
im going to try to build one&nbsp;

so many thx your great project on the lighgun&nbsp;

xox
***@***.***

Original Email

From:"dekkit"< ***@***.*** &gt;;

Sent Time:2024/9/14 13:42

To:"charcole/LCDZapper"< ***@***.*** &gt;;

Cc recipient:"hpx1984"< ***@***.*** &gt;;"Author"< ***@***.*** &gt;;

Subject:Re: [charcole/LCDZapper] any good news about more game console'scable  (Issue #27)

If you scan through the issues, I've attempted to document how a few of the cables were designed / made - so you can build your own if you're keen.

—
Reply to this email directly, view it on GitHub, or unsubscribe.
You are receiving this because you authored the thread.Message ID: ***@***.***&gt;
