charcole/LCDZapper/Firmware/main/images.h

// PNG: 200x80 BitDepth:1 ColourType:3
// Output: 200x80 Depth:3

uint32_t ImagePress12[80][8] = { 
	{ 0x80008000, 0x80008000, 0x80008000, 0x80008000, 0x80008000, 0x80008000, 0x80008000, 0x80008000 },
	{ 0x80008000, 0x80008000, 0x80008000, 0x80008000, 0x80008000, 0x80008000, 0x80008000, 0x80008000 },
	{ 0x80008000, 0x80008000, 0x80008000, 0x80008000, 0x80008000, 0x80008000, 0x80008000, 0x80008000 },
	{ 0x80008000, 0x80008000, 0x80008000, 0x80008000, 0x80008000, 0x80008000, 0x80008000, 0x80008000 },
	{ 0x80008000, 0x80008000, 0x80008000, 0x80008000, 0x80008000, 0x80008000, 0x80008000, 0x80008000 },
	{ 0x80008000, 0x80008000, 0x80008000, 0x80008000, 0x80008000, 0x80008000, 0x80008000, 0x80008000 },
	{ 0x80008000, 0x80008000, 0x80008000, 0x80008000, 0x80008000, 0x80008000, 0x80008000, 0x80008000 },
	{ 0x80008000, 0x80008000, 0x80008000, 0x80008000, 0x80008000, 0x80008000, 0x80008000, 0x80008000 },
	{ 0x80008000, 0x80008000, 0x80008000, 0x80008000, 0x80008000, 0x80008000, 0x80008000, 0x80008000 },
	{ 0x006c873a, 0x002b8478, 0x80008000, 0x80008000, 0x80008000, 0x80008000, 0x80008000, 0x80008000 },
	{ 0x00c2870f, 0x00ac840c, 0x80008000, 0x80008000, 0x80008000, 0x80008000, 0x80008000, 0x80008000 },
	{ 0x010386ee, 0x00ed83cc, 0x80008000, 0x80008000, 0x80008000, 0x80008000, 0x80008000, 0x80008000 },
	{ 0x012e86d9, 0x012e8396, 0x80008000, 0x80008000, 0x80008000, 0x80008000, 0x80008000, 0x80008000 },
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
 36,36,36,36,36,36,36,36,36,36,36,39,36,36,37,36,
 0,1,2,3,4,5,6,7,8,9,38,36,36,36,36,36,
 36,10,11,12,13,14,15,16,17,18,19,20,21,22,23,24,
 25,26,27,28,29,30,31,32,33,34,35,36,36,36,36,36,
 36,10,11,12,13,14,15,16,17,18,19,20,21,22,23,24,
 25,26,27,28,29,30,31,32,33,34,35,36,36,36,36,36,
};
