charcole/LCDZapper/(commit log)

2016-08-07 !F Initial commit of zapper Arduino code
2016-08-14 Add mode to display cursor for a short time after trigger is pulled
    [Zapper.ino]
2016-08-29 Inverted sync line + made light output much shorter to support more machines
    [Zapper.ino]
2016-08-29 Added Raspberry Pi code
2016-08-29 Added schematic of analogue board
2017-04-27 First commit of version 2.0
    [LCDZapperPro.kicad_pcb, LCDZapperPro.sch]
2017-07-01 Added support for calibration
2017-07-01 Added text display for sync and calibration
2017-07-01 Display message when switching co-op mode
2017-07-01 Added description of programmer board
2017-07-01 Uploaded photo of prototype board
2017-07-02 Poll composite sync instead of relying on interrupts (horizontal stability improvement)
    [main.cpp]
2017-07-02 Improve vertical stability and remove need for vertical sync input
    [main.cpp]
2017-07-02 Fix issue with tabs
    [main.cpp]
2017-07-23 Added SCART breakout board for helping use with SuperGun/JAMMA
    [SCARTBreakout.kicad_pcb, SCARTBreakout.sch]
2017-07-25 Fix for vertical jitter (Timer seems dodgy if only reading lower 32bits)
    [main.cpp]
2017-08-13 Schematic redesign
    [LCDZapperPro.sch]
2017-08-20 First layout of version 3
    [LCDZapperPro.kicad_pcb, LCDZapperPro.sch]
2017-08-20 Layout improvements
    [LCDZapperPro.kicad_pcb, LCDZapperPro.sch]
2017-08-20 Increased capacitor sizes
    [LCDZapperPro.kicad_pcb, LCDZapperPro.sch]
2017-08-20 Rotated player 2 GPIO output to match player 1
    [LCDZapperPro.kicad_pcb]
2017-08-22 Add logo to silkscreen
    [LCDZapperPro.kicad_pcb]
2017-08-22 Added SOIC HandSoldering footprint
    [LCDZapperPro.kicad_pcb, LCDZapperPro.sch]
2017-08-22 BAT54S + LED HandSoldering footprints
    [LCDZapperPro.kicad_pcb, LCDZapperPro.sch]
2017-08-23 Improved silkscreen and RCA footprints
    [LCDZapperPro.kicad_pcb]
2017-08-23 Final KiCad files
    [LCDZapperPro.kicad_pcb, LCDZapperPro.sch]
2017-08-23 Select bottom silkscreen to export
    [LCDZapperPro.kicad_pcb]
2017-08-23 Added Gerbers
    [LCDZapperPro-B.Cu.gbr, LCDZapperPro-B.Mask.gbr, LCDZapperPro-B.SilkS.gbr, LCDZapperPro-Edge.Cuts.gbr, LCDZapperPro-F.Cu.gbr, LCDZapperPro-F.Mask.gbr, LCDZapperPro-F.SilkS.gbr, LCDZapperPro-NPTH.drl]
2017-09-16 Reflect changes I made when making the board in schematic
    [LCDZapperPro.sch]
2017-09-16 Version 4 schematic
    [LCDZapperPro.sch]
2017-09-16 Beginning layout
    [LCDZapperPro.kicad_pcb]
2017-09-16 First pass a routing
    [LCDZapperPro.kicad_pcb]
2017-09-16 Completed layout
    [LCDZapperPro.kicad_pcb, LCDZapperPro.sch]
2017-09-17 Front panel PCB
    [FrontPanel.kicad_pcb, FrontPanel.sch]
2017-09-17 Rear panel
    [RearPanel.kicad_pcb, RearPanel.sch]
2017-09-17 Expose ground through screws
    [FrontPanel.kicad_pcb]
2017-09-17 Main board gerbers
    [LCDZapperPro-B.Cu.gbr, LCDZapperPro-B.Mask.gbr, LCDZapperPro-B.SilkS.gbr, LCDZapperPro-Edge.Cuts.gbr, LCDZapperPro-F.Cu.gbr, LCDZapperPro-F.Mask.gbr, LCDZapperPro-F.SilkS.gbr, LCDZapperPro-NPTH.drl]
2017-09-17 Front panel gerbers
    [FrontPanel-B.Cu.gbr, FrontPanel-B.Mask.gbr, FrontPanel-B.SilkS.gbr, FrontPanel-Edge.Cuts.gbr, FrontPanel-F.Cu.gbr, FrontPanel-F.Mask.gbr, FrontPanel-F.SilkS.gbr, FrontPanel-NPTH.drl]
2017-09-17 Rear panel gerbers
    [RearPanel-B.Cu.gbr, RearPanel-B.Mask.gbr, RearPanel-B.SilkS.gbr, RearPanel-Edge.Cuts.gbr, RearPanel-F.Cu.gbr, RearPanel-F.Mask.gbr, RearPanel-F.SilkS.gbr, RearPanel-NPTH.drl]
2017-09-17 Fixes based on print outs
    [FrontPanel-B.Cu.gbr, FrontPanel-B.Mask.gbr, FrontPanel-B.SilkS.gbr, FrontPanel-Edge.Cuts.gbr, FrontPanel-F.Cu.gbr, FrontPanel-F.Mask.gbr, FrontPanel-F.SilkS.gbr, FrontPanel-NPTH.drl]
2017-09-17 Remove info about programmer board as no longer needed
2017-10-03 Switched IO lines to match version 4
2017-10-05 Fix for two player stripiness
    [main.cpp]
2017-10-07 Timing calibration logic
2017-10-08 Fix for LED/Delay triggering
    [main.cpp]
2017-10-08 Added missing values
    [LCDZapperPro.sch]
2017-10-21 Added controls for calibration delay
2017-10-21 Generate variable white level with PWM
2017-10-28 PWM white level, diodes on pullups and white filter
    [LCDZapperPro.sch]
2017-10-28 Make variable resistor optional
    [LCDZapperPro.sch]
2017-10-28 Annotation and footprints
    [LCDZapperPro.sch]
2017-10-28 Added schematic changes to layout
    [LCDZapperPro.kicad_pcb, LCDZapperPro.sch]
2017-10-28 Lengthed the board by 1mm
    [LCDZapperPro.kicad_pcb]
2017-10-28 Updated logos
    [LCDZapperPro.kicad_pcb]
2017-10-28 Update front panel
    [FrontPanel.kicad_pcb]
2017-10-28 Remove out of date Gerbers
    [FrontPanel-B.Cu.gbr, FrontPanel-B.Mask.gbr, FrontPanel-B.SilkS.gbr, FrontPanel-Edge.Cuts.gbr, FrontPanel-F.Cu.gbr, FrontPanel-F.Mask.gbr, FrontPanel-F.SilkS.gbr, FrontPanel-NPTH.drl]
2017-11-05 Cache current line in cause missed due to threading
    [main.cpp]
2017-11-25 Made calibration work with menu
2018-01-07 Added TVS diodes and two channel dimming
    [LCDZapperPro.kicad_pcb, LCDZapperPro.sch]
2018-06-16 Tweaks to front panel LEDs
    [LCDZapperPro.sch]
2018-06-26 Firmware update reset hack
    [main.cpp]
2018-06-27 Initialise more so update shows screen and flash LEDs
2018-06-27 Menu fix (spot generator init moved back to thread)
    [main.cpp]
2018-06-27 NTSC support and better handling of short syncs
    [main.cpp]
2018-06-27 Turn off LEDs on boot to try and avoid burn out
    [main.cpp]
2018-06-28 Updated part selection and fixed symbol issue
    [LCDZapperPro.sch]
2018-06-28 Swapped player 1 and 2 ports so player 1 is left port (layout mistake)
    [LCDZapperPro.kicad_pcb, LCDZapperPro.sch]
2018-06-28 Fix for old header warning in new IDF
    [esp_wiimote.cpp]
2018-06-28 Stopped overflow error repeating incase it's prolonging problem
    [esp_wiimote.cpp]
2018-06-29 Massive stability increase (FreeRTOS unicore + manually managed second core)
    [main.cpp]
2018-07-22 Removed solder paste from ESP32 (as will hand solder) Also improved fab layer
    [LCDZapperPro.kicad_pcb]
2018-07-22 Added pull downs to stop LEDs flashing during reset
    [LCDZapperPro.kicad_pcb, LCDZapperPro.sch]
2018-08-04 Added active cables
2018-08-04 Fixes to serial communication
    [main.cpp]
2018-08-20 Added sustain system to ensure NES compatibility
    [LCDZapperPro.kicad_pcb, LCDZapperPro.sch]
2018-08-20 Opened up new ESP32 pad in solder mask
    [LCDZapperPro.kicad_pcb]
2018-08-27 Updated front/rear panels with new version number
    [FrontPanel.kicad_pcb, RearPanel.kicad_pcb]
2018-11-18 Cable choosing menu, updated logo, added line delay setting
2018-11-27 Fixed some issues with cable selection
    [main.cpp]
2018-12-02 Final settings tweaks and fixed calibration reticule size issue
    [main.cpp]
2018-12-02 Removed border behind menu as glitching looks bad (to restore later)
    [main.cpp]
2018-12-02 Fixed issue when sync source is noisy (eg. my modified Famicom)
    [main.cpp]
2018-12-02 Fix bug causing cable to be saved as custom
    [main.cpp]
2018-12-07 Reverted timing change as caused boot loops (to be investigated)
    [main.cpp]
2019-01-04 Added support for GunCon 2 smart cables
